egilchri/FlyingBlind/hardware/flashlight-case/bezel.stl

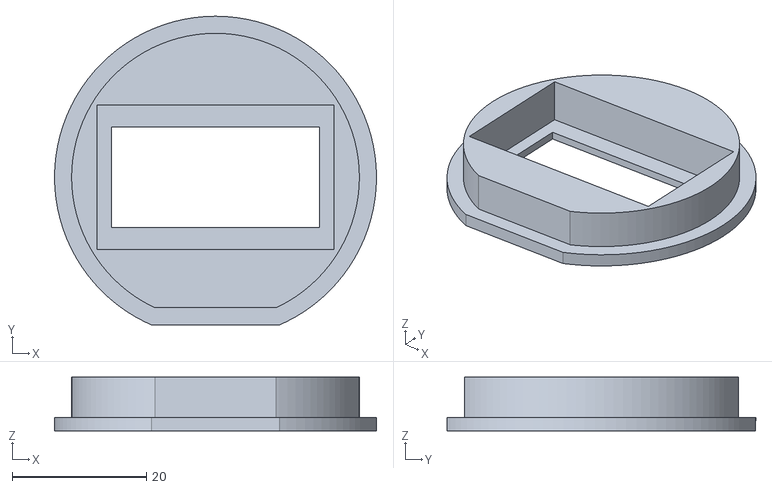
[picture p1: CAD file, 2026-11-12]
hardware/flashlight-case/bezel.stl
48.0 x 46.0 x 8.00
