egilchri/FlyingBlind/hardware/flashlight-case/body.stl

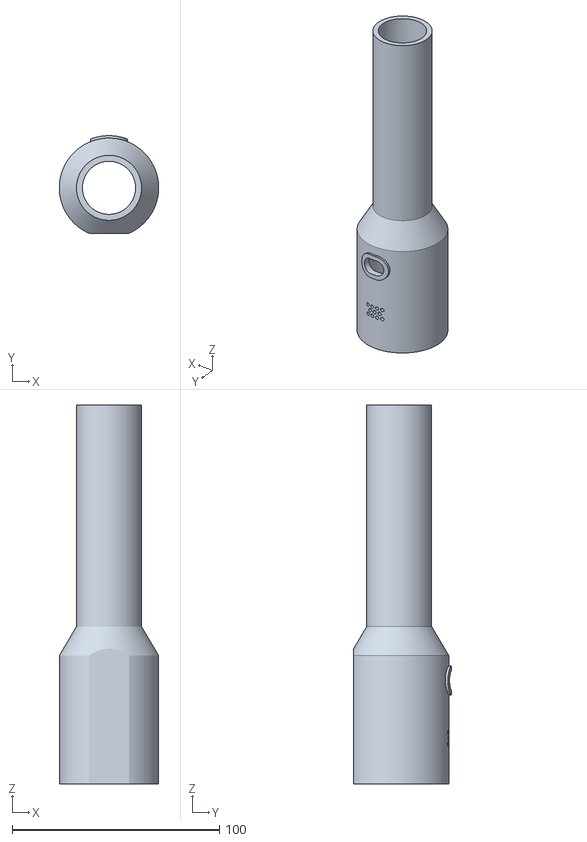
[picture p2: CAD file, 2026-11-12]
hardware/flashlight-case/body.stl
48.0 x 47.2 x 183.0
