egilchri/FlyingBlind/hardware/flashlight-case/cap.stl

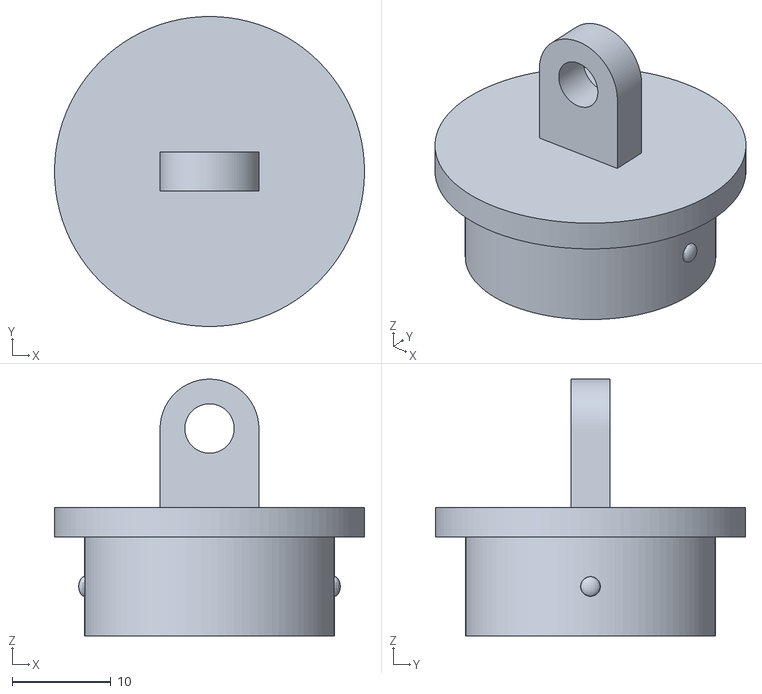
[picture p3: CAD file, 2026-11-10]
hardware/flashlight-case/cap.stl
31.4 x 31.4 x 26.0
