egilchri/FlyingBlind/(commit log)

2026-11-05 Laser distance meter to speech PWA: simulator, DISTO/GLM/explorer drivers, speech formatting
2026-11-06 Tone mode: continuous pitch that follows distance
    - Feedback selector: speak each reading, or play a tone whose pitch glides
    with the latest distance (log scale, closer = higher by default)
    - Tone fades out when readings stop, so silence never means a stale distance
    - Settings for tone range, direction and volume, plus a near-to-far test sweep
    - Simulator "room scan" streams 20 readings/s, aimed by turning the phone
    - README notes that hand-held meters are too slow for real-time scanning
2026-11-06 Sketch ESP32 + TF-Luna LiDAR source for real-time tone scanning
    - firmware/lidar-ble: Arduino sketch that parses TF-Luna/TFmini-S UART frames
    and notifies distance (mm) + strength over BLE at ~50 Hz; reports "no
    target" for weak returns or a silent sensor
    - devices/esp32-lidar.js: matching driver; Measure speaks the latest reading
    - Drivers can flag readings as streamed; speech mode doesn't speak streams,
    and "no target" silences the tone
    - Service worker revalidates with the server so updates aren't served stale
    [lidar-ble.ino]
2026-11-09 Buzzer output for a phone-free LiDAR scanner
    - tone_logic.h: distance -> pitch (log scale, 400-3000 Hz for a piezo,
    closer = higher), ~30 ms glide, silence for sustained "no target",
    and a low tick every 3 s if the sensor stops sending
    - Sketch drives a passive buzzer on GPIO 25 via LEDC (core 2.x and 3.x),
    plays a startup chirp, and still streams readings over BLE
    - Host tests for the tone logic (firmware/test/tone_logic_test.cpp)
    [lidar-ble.ino, tone_logic.h]
2026-11-09 Add 3D picture of the phone-free scanner
    docs/pocket-scanner.html: true-to-size 3D model (power bank, ESP32, buzzer,
    TF-Luna) shown held in a hand; drag to turn, toggle hand/labels/beam.
2026-11-09 Add LiDAR parts list and wiring diagram page
    docs/lidar-parts.html: shopping list with search terms, wiring diagram for
    the buzzer version, and first build steps. Links to the 3D picture.
2026-11-09 Add matchbox and wand scanner designs as 3D pictures
    - docs/matchbox-scanner.html: 46 x 34 x 38 mm case with built-in battery,
    see-inside view, and a comparison with the first version
    - docs/wand-scanner.html: no-solder wand with a lipstick power bank handle,
    held like a flashlight, and a three-way size comparison
    - Rebuilt hand: smooth jointed fingers with nails that follow the fingertip
2026-11-09 Pocket scanner picture: nails follow the back of each fingertip
    The old nails were flattened spheres stuck on the end of each finger.
    Now each is a thin curved shell along the last finger bone, tucked into
    the skin at the edges, with a paler base and free edge. The hand itself
    is unchanged.
2026-11-09 Matchbox and wand pictures: original-style hand with the new nails
    Fingers go back to rounded segments in the original skin tone, keeping
    each design's grip pose. Nails are the curved shells from the pocket
    scanner page.
2026-11-09 Matchbox picture: start with the camera further back
2026-11-10 Add a parts list for the wand scanner
    Shopping list (electronics shared with the first version, plus the
    lipstick power bank, short USB cable, ruler, Velcro straps and foam
    tape), assembly steps, the same wiring diagram, and firmware loading.
2026-11-10 Scanner pictures: smoother, slimmer fingers
    Each finger bone is now a tapered segment with a matching ball at each
    joint, so there are no rings where bones meet. Fingers narrow toward the
    tip and are about 6% slimmer. The pocket scanner's wrist tapers smoothly
    into the forearm. Nails are slightly warmer in color.
2026-11-10 Matchbox picture: softer palm and a slimmer thumb
    The palm is one pillow shape instead of overlapping blobs, with a thumb
    pad and a heel on the little-finger side. The thumb is slimmer and rests
    along the side of the case with its nail showing. The wrist is narrower
    and sits down into the palm.
2026-11-10 Matchbox picture: smooth the wrist
    The forearm is now one turned shape that starts hidden inside the palm,
    narrows slightly at the wrist and widens toward the elbow, replacing the
    cylinder whose rounded end showed as a bulge.
2026-11-10 Matchbox picture: hold it in the palm, poking out past the thumb
    The case now rests in a loosely closed left hand with the sensor end
    sticking out forward between the thumb and index finger. Index and
    middle fingers wrap the side, ring and little fingers curl behind, and
    the thumb rests on top on the raised arrow. The camera starts from the
    front so the lenses are in view.
2026-11-10 Add the no-solder flashlight scanner design
    A 3D picture of the scanner held like a flashlight, so it points where
    the arm points. Same no-solder parts in a printed case: TF-Luna at the
    front, an XIAO ESP32-S3 with pre-soldered pins and the buzzer module in
    the head (grille facing up), and a lipstick power bank in the handle,
    joined by a USB cable whose inline switch sits under the thumb. Includes
    a see-inside view and a comparison with the wand and first version.
2026-11-10 Add a parts list for the flashlight scanner
    Shopping list (XIAO ESP32-S3 with pre-soldered pins, a Y splitter for
    its single GND pin, a USB cable with an inline on/off switch, lipstick
    power bank, printed case, lanyard), assembly steps, XIAO wiring table,
    and firmware notes (the XIAO pin settings are still to be added).
2026-11-10 Add a software design overview; flashlight picture opens without the hand
    docs/software-design.html explains the signal flow (sensor -> firmware
    -> buzzer, optionally -> Bluetooth -> phone app), the firmware's tone
    rules, what each sound means, the app's sources and modes, and where
    each piece lives in the repo. The flashlight picture now starts without
    the hand (the Hand button still shows it), and the flashlight pages link
    to each other and to the overview.
2026-11-10 Firmware: pick pins for the XIAO ESP32-S3; link the flashlight pages
    The firmware now chooses its pins from the board selected in the Arduino
    IDE: the ESP32 DevKit keeps GPIO 16/17/25, and the XIAO ESP32-S3 uses
    D7/D6 for the sensor and D0 for the buzzer. On the XIAO it refuses to
    build unless USB CDC On Boot is enabled, so debug text can't reach the
    sensor on D6/D7. Unknown boards stop with a clear error instead of
    guessing pins.
    The flashlight picture now has links to its parts list and the software
    overview near the top, and both of those link back, so the picture page
    can be shared on its own.
    [lidar-ble.ino]
2026-11-10 Firmware: build for the XIAO ESP32-S3 too
    On the ESP32-S3 the Arduino core (3.x) uses the NimBLE Bluetooth stack,
    whose connect callback passes a connection handle instead of Bluedroid's
    parameter struct. Handle both, so the same sketch builds for the ESP32
    DevKit and the XIAO.
    Checked with arduino-cli and esp32 core 3.3.12: both boards compile, the
    XIAO build stops with a clear message if USB CDC On Boot is off, and an
    unsupported board stops with a clear message instead of guessing pins.
    Not yet run on hardware.
2026-11-10 Add a printable case for the flashlight scanner
    hardware/flashlight-case/ has the OpenSCAD source and three STLs: the
    body (head, neck and handle in one piece), a front bezel that holds the
    TF-Luna, and a tail cap with a lanyard loop. All three are watertight
    and slice in Bambu Studio (A1, 0.20 mm, PLA) with no supports: about
    7 h 45 min and 55 g. Not printed yet.
    Laying out the parts showed the power bank fills the handle, so the
    cable's switch can't sit there. The button now goes on top of the head,
    just ahead of the neck, with a raised rim to find it by touch, which
    makes the scanner 19 cm long. The 3D picture and the parts list are
    updated to match and link to the print files.
    Co-Autho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
    [bezel.stl, body.stl, cap.stl, flashlight-case.scad]
2026-11-10 Flashlight page: add what the sensor can't see
2026-11-12 Flashlight case: give the head a proper flat floor
    The flat cut under the head left the bottom wall 0.4 mm thick. The inside now
    has a flat floor a full wall (2.4 mm) thick, about 18 mm wide, which also
    gives the XIAO board a flat place to sit. The bezel plug gets a matching flat.
    [bezel.stl, body.stl, flashlight-case.scad]
